naokiiwakami/envelope-generator/hardware/envelope-generator.kicad_pcb

## KiCad design hardware/envelope-generator.kicad_pcb (2026-04-16)

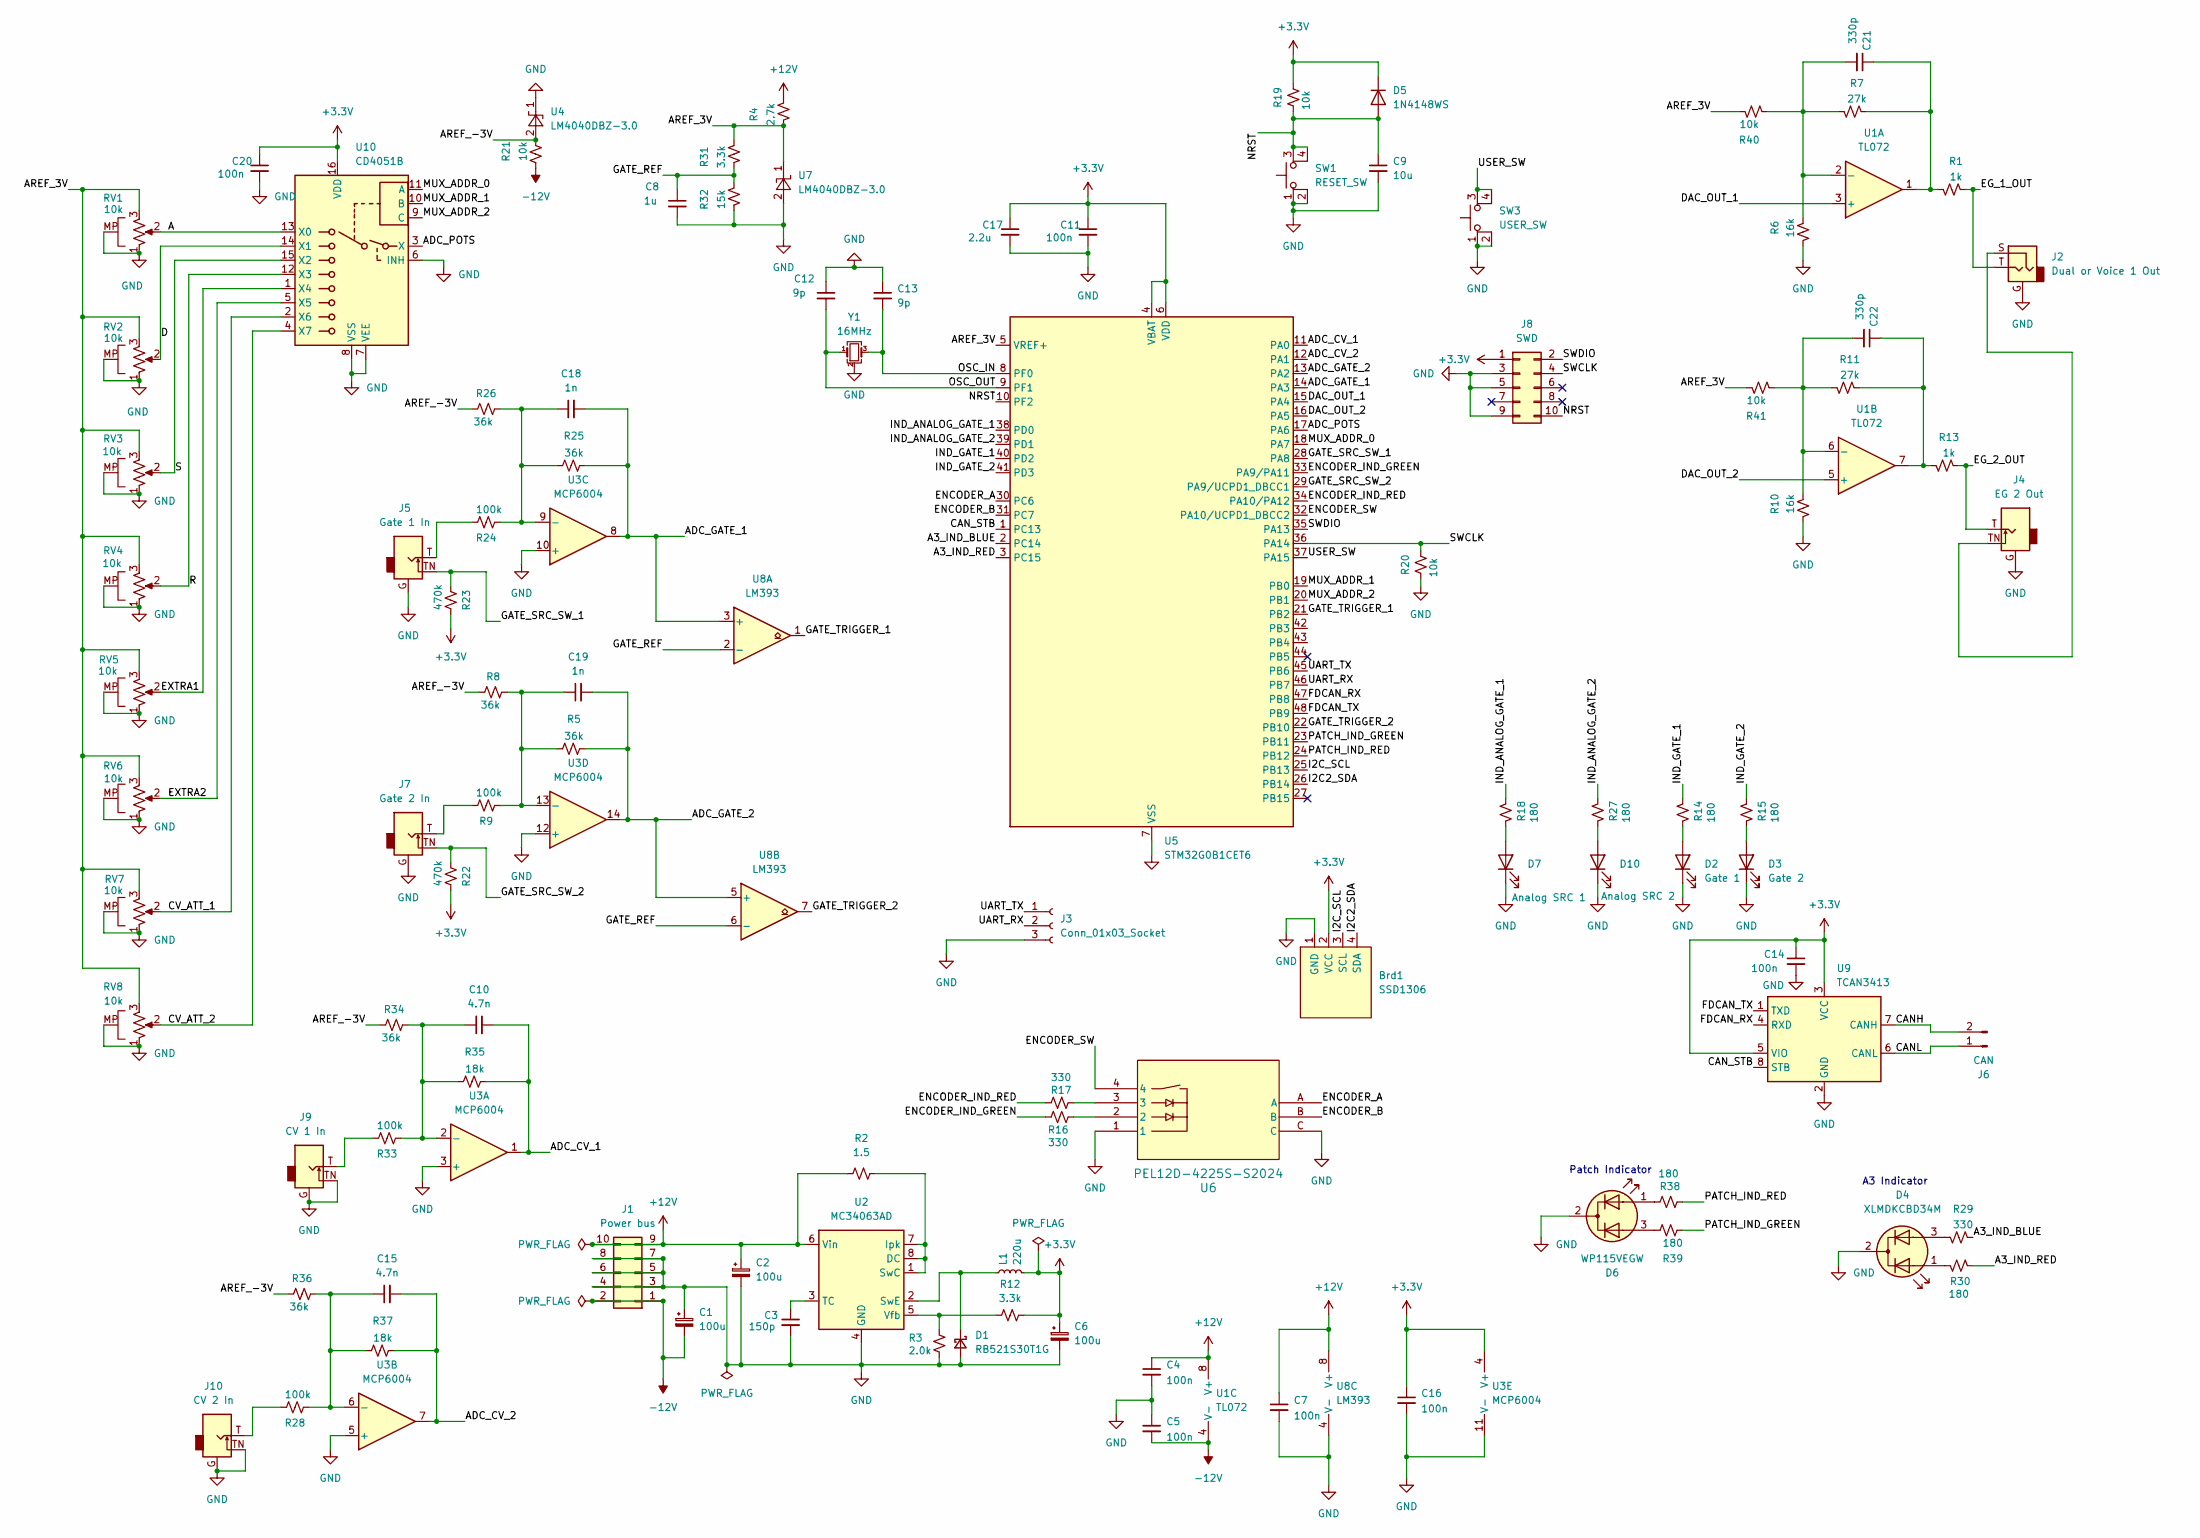
[picture p1: schematic envelope-generator.kicad_sch, Humps D]

Parts:
Brd1: SSD1306; 128x64OLED_aki
C1, C2, C6: 100u; CP_Elec_6.3x5.4_Nichicon
C3: 150p; C_0603_1608Metric
C4, C5, C7, C16: 100n; C_0603_1608Metric
C8: 1u; C_0603_1608Metric_Pad1.08x0.95mm_HandSolder
C9: 10u; C_0805_2012Metric
C10, C15: 4.7n; C_0603_1608Metric_Pad1.08x0.95mm_HandSolder
C11, C14, C20: 100n; C_0603_1608Metric_Pad1.08x0.95mm_HandSolder
C12, C13: 9p; C_0603_1608Metric_Pad1.08x0.95mm_HandSolder
C17: 2.2u; C_0603_1608Metric_Pad1.08x0.95mm_HandSolder
C18, C19: 1n; C_0603_1608Metric_Pad1.08x0.95mm_HandSolder
C21, C22: 330p; C_0603_1608Metric_Pad1.08x0.95mm_HandSolder
D1: RB521S30T1G; D_SOD-523
D2: Gate 1; LED_D3.0mm
D3: Gate 2; LED_D3.0mm
D4: XLMDKCBD34M; LED-3.0mm-3
D5: 1N4148WS; D_SOD-323
D6: WP115VEGW; LED-3.0mm-3
D7: Analog SRC 1; LED_D3.0mm
D10: Analog SRC 2; LED_D3.0mm
J1: Power bus; IDC-Header_2x05_P2.54mm_Vertical
J2: Dual or Voice 1 Out; Thonkiconn_Stereo
J3: Conn_01x03_Socket; PinSocket_1x03_P1.27mm_Vertical
J4: EG 2 Out; Thonkiconn
J5: Gate 1 In; Thonkiconn
J6: CAN; Molex_KK-254_AE-6410-02A_1x02_P2.54mm_Vertical
J7: Gate 2 In; Thonkiconn
J8: SWD; CONN_2x10_3220-10-0100-00_CNC
J9: CV 1 In; Thonkiconn
J10: CV 2 In; Thonkiconn
L1: 220u; L_1210_3225Metric
R1, R13: 1k; R_0603_1608Metric
R2: 1.5; R_0603_1608Metric
R3: 2.0k; R_0603_1608Metric
R4: 2.7k; R_0603_1608Metric_Pad0.98x0.95mm_HandSolder
R5, R8, R25, R26, R34, R36: 36k; R_0603_1608Metric_Pad0.98x0.95mm_HandSolder
R6, R10: 16k; R_0603_1608Metric
R7, R11: 27k; R_0603_1608Metric
R9, R24, R28, R33: 100k; R_0603_1608Metric_Pad0.98x0.95mm_HandSolder
R12: 3.3k; R_0603_1608Metric
R14, R15, R18, R27, R30: 180; R_0603_1608Metric
R16, R17, R29: 330; R_0603_1608Metric
R19, R20, R21: 10k; R_0603_1608Metric_Pad0.98x0.95mm_HandSolder
R22, R23: 470k; R_0603_1608Metric_Pad0.98x0.95mm_HandSolder
R31: 3.3k; R_0603_1608Metric_Pad0.98x0.95mm_HandSolder
R32: 15k; R_0603_1608Metric_Pad0.98x0.95mm_HandSolder
R35, R37: 18k; R_0603_1608Metric_Pad0.98x0.95mm_HandSolder
R38, R39: 180; R_0603_1608Metric_Pad0.98x0.95mm_HandSolder
R40, R41: 10k; R_0603_1608Metric
RV1, RV2, RV3, RV4, RV5, RV6, RV7, RV8: 10k; ALPHA_9MM
SW1: RESET_SW; Panasonic_EVQ_Q2
SW3: USER_SW; SW4_1825910-B_TEC
U1: TL072; SOT-23-8
U2: MC34063AD; SOIC-8_3.9x4.9mm_P1.27mm
U3: MCP6004; SOIC-14_3.9x8.7mm_P1.27mm
U4, U7: LM4040DBZ-3.0; SOT-23
U5: STM32G0B1CET6; LQFP-48_7x7mm_P0.5mm
U6: PEL12D-4225S-S2024; TO_4225S-S2024
U8: LM393; SOIC-8_3.9x4.9mm_P1.27mm
U9: TCAN3413; TSOT-23-8
U10: CD4051B; TSSOP-16_4.4x5mm_P0.65mm
Y1: 16MHz; Crystal_SMD_Abracon_ABM8G-4Pin_3.2x2.5mm

Connections:
+3.3V: Brd1.2 (VCC), C6.1, C11.1, C14.1, C16.1, C17.1, C20.1, D5.1 (K), J8.1, L1.2, R12.1, R19.2, R22.2, R23.2, U3.4 (V+), U5.4 (VBAT), U5.6 (VDD), U9.3 (VCC), U9.5 (VIO), U10.16 (VDD)
+12V: C2.1, C4.1, C7.1, J1.9, J1.10, R2.1, R4.2, U1.8 (V+), U2.6 (Vin), U8.8 (V+)
-12V: C1.2, C5.2, J1.1, J1.2, R21.2, U1.4 (V-)
/A: RV1.2, U10.13 (X0)
/A3_IND_BLUE: R29.1, U5.2 (PC14)
/A3_IND_RED: R30.1, U5.3 (PC15)
/ADC_CV_1: C10.2, R35.1, U3.1, U5.11 (PA0)
/ADC_CV_2: C15.2, R37.1, U3.7, U5.12 (PA1)
/ADC_GATE_1: C18.2, R25.1, U3.8, U5.14 (PA3), U8.3 (+)
/ADC_GATE_2: C19.2, R5.1, U3.14, U5.13 (PA2), U8.5 (+)
/ADC_POTS: U5.17 (PA6), U10.3 (X)
/AREF_3V: R4.1, R31.2, R40.1, R41.1, RV1.3, RV2.3, RV3.3, RV4.3, RV5.3, RV6.3, RV7.3, RV8.3, U5.5 (VREF+), U7.1 (K)
/AREF_-3V: R8.1, R21.1, R26.1, R34.1, R36.1, U4.2 (A)
/CANH: J6.2, U9.7 (CANH)
/CANL: J6.1, U9.6 (CANL)
/CAN_STB: U5.1 (PC13), U9.8 (STB)
/CV_ATT_1: RV7.2, U10.2 (X6)
/CV_ATT_2: RV8.2, U10.4 (X7)
/D: RV2.2, U10.14 (X1)
/DAC_OUT_1: U1.3 (+), U5.15 (PA4)
/DAC_OUT_2: U1.5 (+), U5.16 (PA5)
/EG_1_OUT: J2.T, R1.1
/EG_2_OUT: J4.T, R13.1
/ENCODER_A: U5.30 (PC6), U6.A
/ENCODER_B: U5.31 (PC7), U6.B
/ENCODER_IND_GREEN: R16.1, U5.33 (PA9/PA11)
/ENCODER_IND_RED: R17.2, U5.34 (PA10/PA12)
/ENCODER_SW: U5.32 (PA10/UCPD1_DBCC2), U6.4
/EXTRA1: RV5.2, U10.1 (X4)
/EXTRA2: RV6.2, U10.5 (X5)
/FDCAN_RX: U5.47 (PB8), U9.4 (RXD)
/FDCAN_TX: U5.48 (PB9), U9.1 (TXD)
/GATE_REF: C8.1, R31.1, R32.2, U8.2 (-), U8.6 (-)
/GATE_SRC_SW_1: J5.TN, R23.1, U5.28 (PA8)
/GATE_SRC_SW_2: J7.TN, R22.1, U5.29 (PA9/UCPD1_DBCC1)
/GATE_TRIGGER_1: U5.21 (PB2), U8.1
/GATE_TRIGGER_2: U5.22 (PB10), U8.7
/I2C2_SDA: Brd1.4 (SDA), U5.26 (PB14)
/I2C_SCL: Brd1.3 (SCL), U5.25 (PB13)
/IND_ANALOG_GATE_1: R18.1, U5.38 (PD0)
/IND_ANALOG_GATE_2: R27.1, U5.39 (PD1)
/IND_GATE_1: R14.1, U5.40 (PD2)
/IND_GATE_2: R15.1, U5.41 (PD3)
/MUX_ADDR_0: U5.18 (PA7), U10.11 (A)
/MUX_ADDR_1: U5.19 (PB0), U10.10 (B)
/MUX_ADDR_2: U5.20 (PB1), U10.9 (C)
/NRST: C9.1, D5.2 (A), J8.10, R19.1, SW1.3, SW1.4, U5.10 (PF2)
/OSC_IN: C13.2, U5.8 (PF0), Y1.3
/OSC_OUT: C12.2, U5.9 (PF1), Y1.1
/PATCH_IND_GREEN: R39.1, U5.23 (PB11)
/PATCH_IND_RED: R38.1, U5.24 (PB12)
/R: RV4.2, U10.12 (X3)
/S: RV3.2, U10.15 (X2)
/SWCLK: J8.4, R20.2, U5.36 (PA14)
/SWDIO: J8.2, U5.35 (PA13)
/UART_RX: J3.2, U5.46 (PB7)
/UART_TX: J3.1, U5.45 (PB6)
/USER_SW: SW3.3, SW3.4, U5.37 (PA15)
GND: Brd1.1 (GND), C1.1, C2.2, C3.2, C4.2, C5.1, C6.2, C7.2, C8.2, C9.2, C11.2, C12.1, C13.1, C14.2, C16.2, C17.2, C20.2, D1.2 (A), D2.1 (K), D3.1 (K), D4.2 (K), D6.2 (K), D7.1 (K), D10.1 (K), J1.3, J1.4, J1.5, J1.6, J1.7, J1.8, J2.G, J3.3, J4.G, J5.G, J7.G, J8.3, J8.5, J8.9, J9.G, J9.TN, J10.G, J10.TN, R3.1, R6.2, R10.2, R20.1, R32.1, RV1.1, RV1.MP, RV2.1, RV2.MP, RV3.1, RV3.MP, RV4.1, RV4.MP, RV5.1, RV5.MP, RV6.1, RV6.MP, RV7.1, RV7.MP, RV8.1, RV8.MP, SW1.1, SW1.2, SW3.1, SW3.2, U2.4 (GND), U3.3 (+), U3.5 (+), U3.10 (+), U3.11 (V-), U3.12 (+), U4.1 (K), U5.7 (VSS), U6.1, U6.C, U7.2 (A), U8.4 (V-), U9.2 (GND), U10.6 (INH), U10.7 (VEE), U10.8 (VSS), Y1.2 (G), Y1.4 (G)
unnamed: C21.1, R1.2, R7.1, U1.1
unnamed: C22.1, R11.1, R13.2, U1.7
unnamed: D1.1 (K), L1.1, U2.2 (SwE)
unnamed: D2.2 (A), R14.2
unnamed: D3.2 (A), R15.2
unnamed: D4.1 (A1), R30.2
unnamed: D4.3 (A2), R29.2
unnamed: D6.1 (A1), R38.2
unnamed: D6.3 (A2), R39.2
unnamed: D7.2 (A), R18.2
unnamed: D10.2 (A), R27.2
unnamed: J2.S, J4.TN
unnamed: J5.T, R24.2
unnamed: J7.T, R9.2
unnamed: J9.T, R33.2
unnamed: J10.T, R28.2
unnamed: R16.2, U6.2
unnamed: R17.1, U6.3
unnamed: C21.2, R6.1, R7.2, R40.2, U1.2 (-)
unnamed: C22.2, R10.1, R11.2, R41.2, U1.6 (-)
unnamed: R2.2, U2.1 (SwC), U2.7 (Ipk), U2.8 (DC)
unnamed: C3.1, U2.3 (TC)
unnamed: R3.2, R12.2, U2.5 (Vfb)
unnamed: C10.1, R33.1, R34.2, R35.2, U3.2 (-)
unnamed: C15.1, R28.1, R36.2, R37.2, U3.6 (-)
unnamed: C18.1, R24.1, R25.2, R26.2, U3.9 (-)
unnamed: C19.1, R5.2, R8.2, R9.1, U3.13 (-)

Notes on the sheet:
Patch Indicator
A3 Indicator

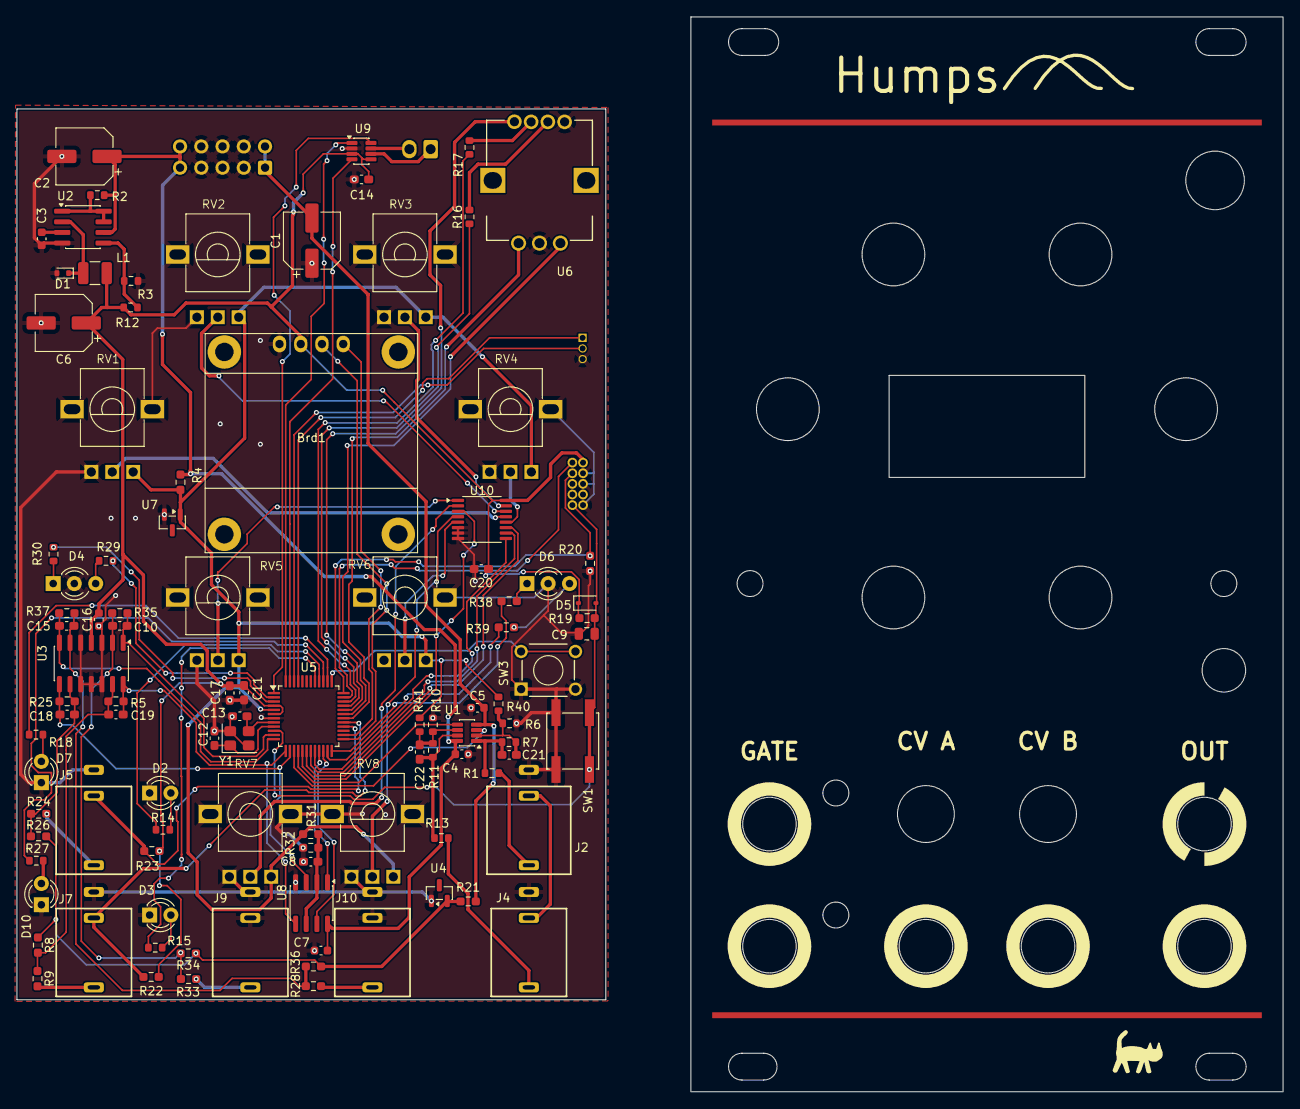
[picture p2: board envelope-generator.kicad_pcb from above]

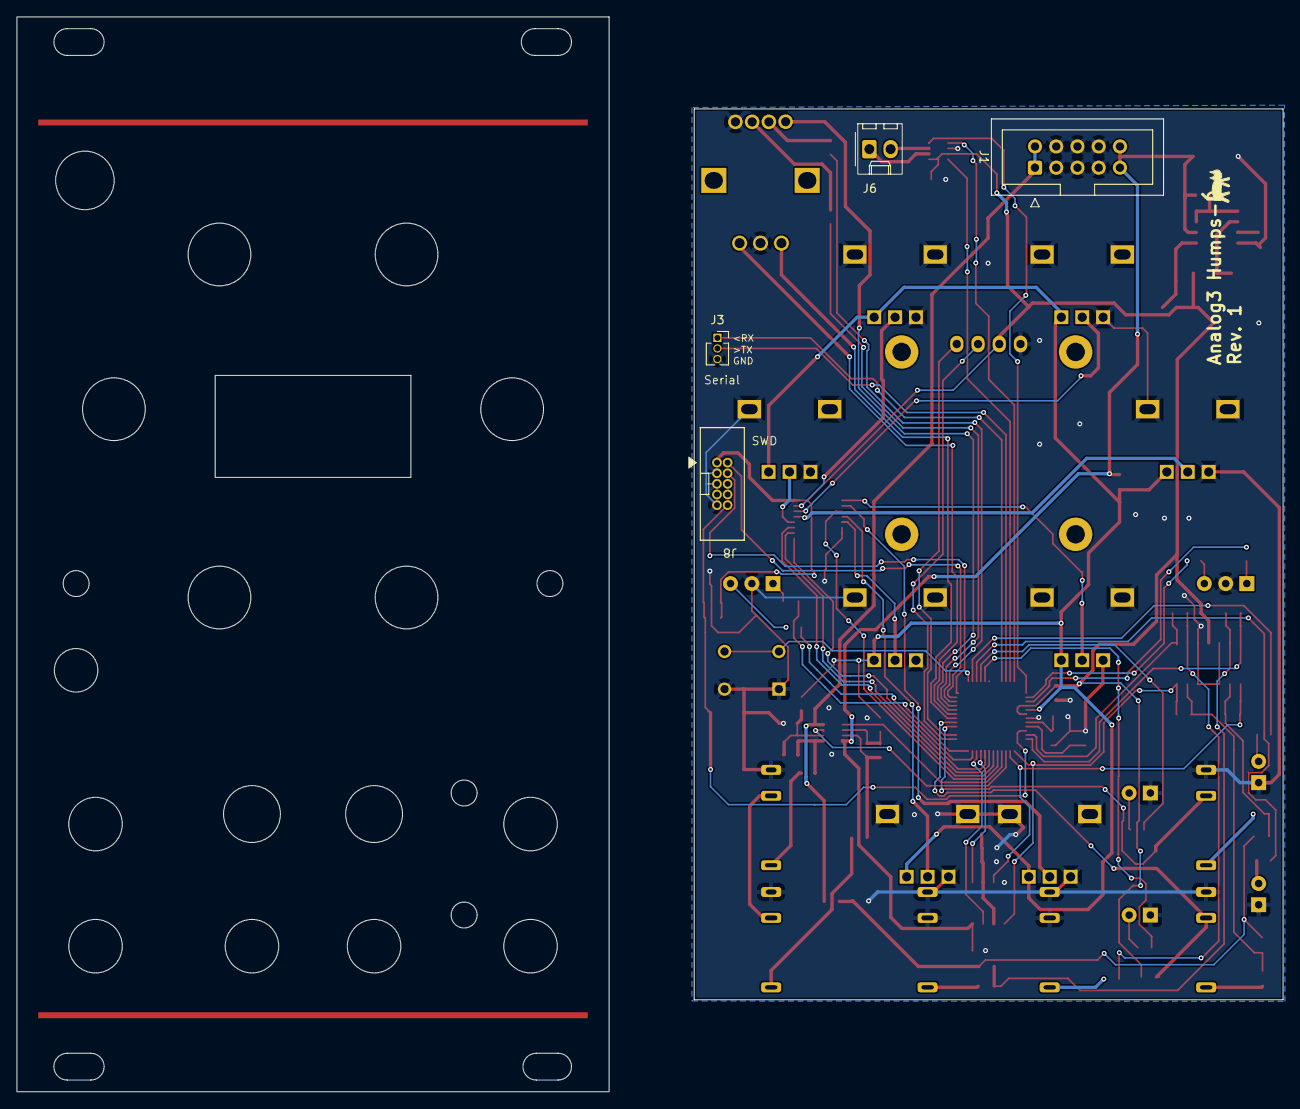
[picture p3: board envelope-generator.kicad_pcb from below]

Board: 2 copper layers, 70.4 x 106.5 mm, 105 parts (4 on the bottom side), 86 nets.

Other parts of the board:
SSD1306: 128x64OLED; 128x64 OLED Window
