naokiiwakami/envelope-generator/firmware/src/input_reader.rs

use analog3::{
    definitions::Value,
    storage::{self, load_u16},
};
use defmt::{self, debug};
use embassy_executor::Spawner;
use embassy_futures::select::{Either, select};
use embassy_stm32::{
    Peri,
    adc::{Adc, SampleTime},
    dma,
    exti::ExtiInput,
    flash::Error,
    gpio::{Input, Level, Output},
    mode::Async,
    peripherals::*,
};
use embassy_stm32::{adc::AdcChannel, bind_interrupts};
use embassy_sync::{
    blocking_mutex::raw::ThreadModeRawMutex,
    channel::{self, Channel},
    signal::Signal,
    watch::{self, Watch},
};
use embassy_time::Timer;

use crate::{
    addresses::{ADDR_CV_OFFSET_A, ADDR_GATE_TRIGGER_POINT_1},
    definitions::{PotKind, Reply},
    envelope_generator::{
        EG_CHANNEL_SIZE, EgRequest, GateEventType, VoiceId, get_eg_request_sender,
    },
};

bind_interrupts!(struct Irqs {
    DMA1_CHANNEL1 => dma::InterruptHandler<DMA1_CH1>;
});

// communications ///////////////////////////////
static WATCH_READER: Watch<ThreadModeRawMutex, InputReaderInfo, 2> = Watch::new();
static CHANNEL_REQUEST: Channel<ThreadModeRawMutex, InputReaderRequest, 2> = Channel::new();
static SIGNAL_GATE_1_READING: Signal<ThreadModeRawMutex, u16> = Signal::new();
static SIGNAL_GATE_2_READING: Signal<ThreadModeRawMutex, u16> = Signal::new();
static SIGNAL_STORAGE: Signal<ThreadModeRawMutex, Result<Value, Error>> = Signal::new();

/// ADC resources
pub struct AdcResources {
    pub adc: Adc<'static, ADC1>,
    pub dma: Peri<'static, DMA1_CH1>,

    pub mux_addr_0: Output<'static>,
    pub mux_addr_1: Output<'static>,
    pub mux_addr_2: Output<'static>,

    pub pots: Peri<'static, PA6>,

    pub gate_1: Peri<'static, PA3>,
    pub gate_2: Peri<'static, PA2>,

    pub cv_a: Peri<'static, PA0>,
    pub cv_b: Peri<'static, PA1>,
}

#[derive(Clone)]
pub struct PotInfo {
    pub kind: PotKind,
    pub value: u16,
}

#[derive(Clone)]
pub struct CvInfo {
    pub cv_a: i16,
    pub cv_b: i16,
}

#[derive(Clone)]
pub struct InputReaderInfo {
    pub pot_info: PotInfo,
    pub cv_info: CvInfo,
}

impl InputReaderInfo {
    /// create a blank info
    pub fn new(pot_kind: PotKind) -> Self {
        Self {
            pot_info: PotInfo {
                kind: pot_kind,
                value: 0,
            },
            cv_info: CvInfo { cv_a: 0, cv_b: 0 },
        }
    }
}

pub enum InputReaderRequest {
    ReadVelocity {
        voice_id: VoiceId,
    },
    SetCvOffsets {
        offset_a: i16,
        offset_b: i16,
        save: bool,
    },
    SmashForGateOffset {
        voice_id: VoiceId,
        reply: &'static Signal<ThreadModeRawMutex, Reply>,
    },
}

pub async fn start(
    spawner: Spawner,
    resources: AdcResources,
    gate_src_sw_1: Input<'static>,
    gate_src_sw_2: Input<'static>,
    ind_analog_gate_1: Output<'static>,
    ind_analog_gate_2: Output<'static>,
    gate_trigger_1: ExtiInput<'static, Async>,
    gate_trigger_2: ExtiInput<'static, Async>,
) {
    let mut input_reader = InputReader::new(resources);
    input_reader.load_cv_offsets().await;
    input_reader.load_gate_offsets().await;
    spawner.spawn(run_input_reader(input_reader).unwrap());
    let physical_gate_1 = PhysicalGate::new(
        gate_src_sw_1,
        ind_analog_gate_1,
        gate_trigger_1,
        VoiceId::Voice1,
    );
    let physical_gate_2 = PhysicalGate::new(
        gate_src_sw_2,
        ind_analog_gate_2,
        gate_trigger_2,
        VoiceId::Voice2,
    );
    spawner.spawn(run_physical_gate(physical_gate_1).unwrap());
    spawner.spawn(run_physical_gate(physical_gate_2).unwrap());
}

#[inline]
async fn get_change_receiver<T>(
    watch: &'static Watch<ThreadModeRawMutex, T, 2>,
) -> watch::Receiver<'static, ThreadModeRawMutex, T, 2>
where
    T: Clone,
{
    let mut sleep_millis = 1;
    loop {
        if let Some(receiver) = watch.receiver() {
            return receiver;
        }
        // exponential back off
        Timer::after_millis(sleep_millis).await;
        sleep_millis *= 2;
    }
}

pub async fn get_reader_info_receiver()
-> watch::Receiver<'static, ThreadModeRawMutex, InputReaderInfo, 2> {
    get_change_receiver(&WATCH_READER).await
}

pub fn get_reader_request_sender()
-> channel::Sender<'static, ThreadModeRawMutex, InputReaderRequest, 2> {
    CHANNEL_REQUEST.sender()
}

static MUX_ADDRESSES: [(Level, Level, Level, PotKind); 8] = [
    (Level::Low, Level::Low, Level::Low, PotKind::Attack),
    (Level::Low, Level::Low, Level::High, PotKind::Decay),
    (Level::Low, Level::High, Level::Low, PotKind::Sustain),
    (Level::Low, Level::High, Level::High, PotKind::Release),
    (Level::High, Level::Low, Level::Low, PotKind::Extra1),
    (Level::High, Level::Low, Level::High, PotKind::Extra2),
    (Level::High, Level::High, Level::Low, PotKind::CvDepthA),
    (Level::High, Level::High, Level::High, PotKind::CvDepthB),
];

#[embassy_executor::task]
async fn run_input_reader(mut input_reader: InputReader) {
    input_reader.run().await;
}

struct InputReader {
    // peripherals
    resources: AdcResources,

    // pot reading
    pot_index: usize,

    // CV offsets
    cv_offset_a: i16,
    cv_offset_b: i16,

    // gate offsets
    gate_offset: [u16; 2],
}

impl InputReader {
    pub fn new(resources: AdcResources) -> Self {
        Self {
            resources,
            pot_index: 0,
            cv_offset_a: 0,
            cv_offset_b: 0,
            gate_offset: [0; 2],
        }
    }

    pub async fn run(&mut self) {
        let request_receiver = CHANNEL_REQUEST.receiver();
        let mut reader_info_sender = WATCH_READER.sender();
        loop {
            match select(Timer::after_millis(10), request_receiver.receive()).await {
                Either::First(()) => {}
                Either::Second(request) => match request {
                    InputReaderRequest::ReadVelocity { voice_id } => {
                        self.read_velocity(voice_id).await
                    }
                    InputReaderRequest::SetCvOffsets {
                        offset_a,
                        offset_b,
                        save,
                    } => self.set_cv_offsets(offset_a, offset_b, save).await,
                    InputReaderRequest::SmashForGateOffset { voice_id, reply } => {
                        self.set_gate_offset(voice_id).await;
                        reply.signal(Reply::Void);
                    }
                },
            }
            self.regular_reading(&mut reader_info_sender).await;
        }
    }

    async fn regular_reading(
        &mut self,
        reader_info_sender: &mut watch::Sender<'_, ThreadModeRawMutex, InputReaderInfo, 2>,
    ) {
        let (pot_info, cv_info) = self.run_adc(self.pot_index).await;
        self.pot_index = (self.pot_index + 1) % MUX_ADDRESSES.len();
        reader_info_sender.send(InputReaderInfo { pot_info, cv_info });
    }

    async fn run_adc(&mut self, index: usize) -> (PotInfo, CvInfo) {
        // Set up the pot multiplexer
        let (addr2, addr1, addr0, kind) = &MUX_ADDRESSES[index];
        self.resources.mux_addr_0.set_level(*addr0);
        self.resources.mux_addr_1.set_level(*addr1);
        self.resources.mux_addr_2.set_level(*addr2);

        // run ADC
        let mut buffer = [0u16; 3];
        let mut pots = self.resources.pots.degrade_adc();
        let mut cv_a = self.resources.cv_a.degrade_adc();
        let mut cv_b = self.resources.cv_b.degrade_adc();
        let sequence = [
            (&mut pots, SampleTime::Cycles1605),
            (&mut cv_a, SampleTime::Cycles1605),
            (&mut cv_b, SampleTime::Cycles1605),
        ]
        .into_iter();
        self.resources
            .adc
            .read(
                self.resources.dma.reborrow(),
                Irqs,
                sequence,
                None,
                &mut buffer,
            )
            .await;

        // Pots pick up noise so their values do not drop to zero at the bottoms.
        // It causes noticable slight level at the edge of the configuration.
        // We subtract 4 from the original value to mitigate this problem.
        let pot_value = if buffer[2] >= 4 {
            (buffer[2] - 4) << 4
        } else {
            0
        };

        let cv_a = 32767 + self.cv_offset_a - (buffer[0] << 4) as i16;
        let cv_b = 32767 + self.cv_offset_b - (buffer[1] << 4) as i16;

        (
            PotInfo {
                kind: *kind,
                value: pot_value,
            },
            CvInfo { cv_a, cv_b },
        )
    }

    async fn read_velocity(&mut self, voice_id: VoiceId) {
        let reading = self.read_gate_value(voice_id).await;
        let offset = self.gate_offset[voice_id as usize];
        let velocity = reading.max(offset) - offset;

        match voice_id {
            VoiceId::Voice1 => SIGNAL_GATE_1_READING.signal(velocity),
            VoiceId::Voice2 => SIGNAL_GATE_2_READING.signal(velocity),
        }
    }

    async fn set_cv_offsets(&mut self, offset_a: i16, offset_b: i16, save: bool) {
        debug!("SetCvOffsets received: {:#x} {:#x}", offset_a, offset_b);
        self.cv_offset_a = offset_a;
        self.cv_offset_b = offset_b;
        if save {
            self.save_cv_offsets().await;
        }
    }

    async fn set_gate_offset(&mut self, voice_id: VoiceId) {
        let reading = self.read_gate_value(voice_id).await;
        self.gate_offset[voice_id as usize] = reading.max(10) - 10;
        debug!(
            "gate offset {}={}",
            voice_id as usize, self.gate_offset[voice_id as usize]
        );
        Self::save_gate_offset(voice_id as u16, reading).await;
    }

    async fn read_gate_value(&mut self, voice_id: VoiceId) -> u16 {
        let mut buffer = [0u16; 1];
        let channel = match voice_id {
            VoiceId::Voice1 => &mut self.resources.gate_1.degrade_adc(),
            VoiceId::Voice2 => &mut self.resources.gate_2.degrade_adc(),
        };
        let sequence = [(channel, SampleTime::Cycles1605)].into_iter();
        self.resources
            .adc
            .read(
                self.resources.dma.reborrow(),
                Irqs,
                sequence,
                None,
                &mut buffer,
            )
            .await;

        let reading = !((buffer[0]) << 4);
        reading
    }

    pub async fn load_cv_offsets(&mut self) {
        self.cv_offset_a = Self::load_cv_offset(0).await;
        self.cv_offset_b = Self::load_cv_offset(1).await;
        debug!(
            "loaded CV offsets: a={}, b={}",
            self.cv_offset_a, self.cv_offset_b
        );
    }

    async fn load_cv_offset(index: u16) -> i16 {
        let saved_offset = load_u16(ADDR_CV_OFFSET_A + index * 2, &SIGNAL_STORAGE).await;
        if saved_offset == u16::MAX {
            0
        } else {
            (saved_offset as i32 - 0x8000) as i16
        }
    }

    async fn save_cv_offsets(&mut self) {
        Self::save_cv_offset(0, self.cv_offset_a).await;
        Self::save_cv_offset(1, self.cv_offset_b).await;
    }

    async fn save_cv_offset(index: u16, offset: i16) {
        let save_value = (offset as i32 + 0x8000) as u16;
        storage::save(
            ADDR_CV_OFFSET_A + index * 2,
            Value::U16(save_value),
            &SIGNAL_STORAGE,
        )
        .await
        .unwrap();
    }

    pub async fn load_gate_offsets(&mut self) {
        self.gate_offset[0] = Self::load_gate_offset(0).await;
        self.gate_offset[1] = Self::load_gate_offset(1).await;
        debug!(
            "loaded CV offsets: a={}, b={}",
            self.cv_offset_a, self.cv_offset_b
        );
    }

    async fn load_gate_offset(index: u16) -> u16 {
        let saved_offset = load_u16(ADDR_GATE_TRIGGER_POINT_1 + index * 2, &SIGNAL_STORAGE).await;
        if saved_offset == u16::MAX {
            0
        } else {
            saved_offset
        }
    }

    async fn save_gate_offset(index: u16, offset: u16) {
        storage::save(
            ADDR_GATE_TRIGGER_POINT_1 + index * 2,
            Value::U16(offset),
            &SIGNAL_STORAGE,
        )
        .await
        .unwrap();
    }
}

#[embassy_executor::task(pool_size = 2)]
async fn run_physical_gate(mut analog_gate: PhysicalGate) {
    analog_gate.run().await;
}

struct PhysicalGate {
    src_sw: Input<'static>,
    ind_analog_gate: Output<'static>,
    trigger: ExtiInput<'static, Async>,

    voice_id: VoiceId,
    state: PhysicalGateState,

    request_sender: channel::Sender<'static, ThreadModeRawMutex, EgRequest, EG_CHANNEL_SIZE>,
}

impl PhysicalGate {
    pub fn new(
        src_sw: Input<'static>,
        ind_analog_gate: Output<'static>,
        trigger: ExtiInput<'static, Async>,
        voice_id: VoiceId,
    ) -> Self {
        Self {
            src_sw,
            ind_analog_gate,
            trigger,
            voice_id,
            state: PhysicalGateState::Disabled,
            request_sender: get_eg_request_sender(),
        }
    }

    pub async fn run(&mut self) {
        loop {
            match self.state {
                PhysicalGateState::Disabled => {
                    Timer::after_millis(10).await;
                    if self.src_sw.is_high() {
                        debug!(
                            "Physical gate {:?} enabled, state={:?}",
                            self.voice_id, self.state
                        );
                        self.state = PhysicalGateState::GateOff;
                        self.ind_analog_gate.set_high();
                        self.request_sender
                            .send(EgRequest::GateEvent {
                                id: self.voice_id.clone(),
                                event: GateEventType::PhysicalGateEnabled,
                            })
                            .await;
                    }
                }
                _ => self.run_analog_gate().await,
            }
        }
    }

    async fn run_analog_gate(&mut self) {
        let mut request_sender = CHANNEL_REQUEST.sender();
        loop {
            match self.state {
                PhysicalGateState::Disabled => {
                    break;
                }
                PhysicalGateState::GateOff => match select(
                    self.trigger.wait_for_falling_edge(),
                    Timer::after_millis(10),
                )
                .await
                {
                    Either::First(()) => self.handle_gate_on(&mut request_sender).await,
                    Either::Second(()) => self.check_gate_switch().await,
                },
                PhysicalGateState::GateOn => {
                    match select(self.trigger.wait_for_rising_edge(), Timer::after_millis(10)).await
                    {
                        Either::First(()) => self.handle_gate_off().await,
                        Either::Second(()) => self.check_gate_switch().await,
                    }
                }
            }
        }
    }

    async fn handle_gate_on(
        &mut self,
        sender: &mut channel::Sender<'static, ThreadModeRawMutex, InputReaderRequest, 2>,
    ) {
        self.state = PhysicalGateState::GateOn;
        debug!("gate on");
        Timer::after_micros(500).await;
        sender
            .send(InputReaderRequest::ReadVelocity {
                voice_id: self.voice_id.clone(),
            })
            .await;
        let velocity: u16 = match self.voice_id {
            VoiceId::Voice1 => SIGNAL_GATE_1_READING.wait().await,
            VoiceId::Voice2 => SIGNAL_GATE_2_READING.wait().await,
        };
        self.request_sender
            .send(EgRequest::GateEvent {
                id: self.voice_id.clone(),
                event: GateEventType::GateOn { velocity },
            })
            .await;
    }

    async fn handle_gate_off(&mut self) {
        self.state = PhysicalGateState::GateOff;
        self.request_sender
            .send(EgRequest::GateEvent {
                id: self.voice_id.clone(),
                event: GateEventType::GateOff,
            })
            .await;
    }

    async fn check_gate_switch(&mut self) {
        // TODO: assert physical gate enabled
        if self.src_sw.is_low() {
            debug!(
                "Physical gate {:?} disabled, state={:?}",
                self.voice_id, self.state
            );
            if !matches!(self.state, PhysicalGateState::GateOff) {
                self.request_sender
                    .send(EgRequest::GateEvent {
                        id: self.voice_id.clone(),
                        event: GateEventType::GateOff,
                    })
                    .await;
            }
            self.request_sender
                .send(EgRequest::GateEvent {
                    id: self.voice_id.clone(),
                    event: GateEventType::PhysicalGateDisabled,
                })
                .await;
            self.ind_analog_gate.set_low();
            self.state = PhysicalGateState::Disabled
        }
    }
}

#[derive(Debug, defmt::Format)]
enum PhysicalGateState {
    Disabled,
    GateOff,
    GateOn,
}
