naokiiwakami/envelope-generator/firmware/src/control_panel/display/definitions.rs

pub const LEFT: i32 = 0;
pub const RIGHT: i32 = 127;
pub const TOP: i32 = 0;
pub const BOTTOM: i32 = 28;
pub const N_BOTTOM: i32 = 56;
pub const EDGE_BOTTOM: i32 = 63;
pub const LOWER_BASELINE: i32 = EDGE_BOTTOM - 14;
