naokiiwakami/envelope-generator/firmware/src/envelope_generator/calib_engine.rs

use crate::envelope_generator::OutputPolarity;
use crate::input_reader::InputReaderInfo;

use super::config::EgConfig;
use super::definitions::{Engine, VoiceParams};

pub struct CalibEngine {
    polarity: OutputPolarity,
}

impl Engine for CalibEngine {
    fn new() -> Self {
        Self {
            polarity: OutputPolarity::Positive,
        }
    }

    fn initialize(&mut self, _voice_index: usize, _config: &EgConfig) {}

    fn update_params(&mut self, voice_index: usize, config: &EgConfig, _input: &InputReaderInfo) {
        self.polarity = config.out_polarity(voice_index);
    }

    fn gate_on(&mut self, _params: &VoiceParams) {}

    fn gate_off(&mut self) {}

    /// Generates triangular wave
    fn update(&mut self, params: &VoiceParams) -> u16 {
        let out = params.output_level + params.out_zero_point;
        out
    }
}
