naokiiwakami/envelope-generator/(commit log)

2025-11-30 Merge PoC code (#1)
    * initial commit
    * Introduce new component 'EnvelopeGenerator'
    * Generalize MCP47x6 DAC handling methods
    * Make release time configurable
    * Initial ADSR implementation
    * minor fixes
    * Improve mechanism to update envelope generator units to eliminate intermittent pop noises
    * Fix bugs
    * Double precision of envelope calculation
    * bugfix
    * Avoid calculations in interrupt handlers
    * try ADDSR
    * Try PWM
    * Consolidate timer to update EG to TIM3 to avoid potential risk of beating effect
    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
    [envelope-generator.kicad_pcb, envelope-generator.kicad_sch]
2026-02-15 PCB design the first iteration
    [envelope-generator.kicad_pcb, envelope-generator.kicad_sch]
2026-03-13 humps rev 0
    [envelope-generator.kicad_pcb, envelope-generator.kicad_sch]
2026-03-13 (try to) fix bug in menu index tracking
    [control_panel.rs]
2026-03-16 Add functionality to switch EG type
2026-03-18 Enable showing current engine type
2026-03-18 Add basic framework to display for each engine type
2026-03-18 Issue 6 (#10)
    * Add basic framework to display for each engine type
    * Start using fixed
    * Replace values in ADSR engine by fixed types
    * Use fixed for the ADDSR engine
    * Reverse the polarity of delta
    * Rename AddsrEngine to TwoDecaysEngine
    [envelope_generator.rs, two_decays_engine.rs]
2026-03-19 fix a bug in displaying pot position
    [display.rs]
2026-03-19 Issue #11 - Simplify the ADSR engine implementation
    [adsr_engine.rs, definitions.rs, envelope_generator.rs, linear_engine.rs, menu.rs, two_decays_engine.rs]
2026-03-19 Issue #2 - Replace watches for receiving reply by signals
    [control_panel.rs, diagnoser.rs, envelope_generator.rs, mod.rs, patch_controller.rs]
2026-03-20 issue #16 Eliminate dependency on crate fixed
    [adsr_engine.rs, definitions.rs, linear_engine.rs, two_decays_engine.rs]
2026-03-20 Issue #8 Add new engine "ParaDecays" (#17)
    * Adding adsr-dd, wip
    * Done with initial implementation of adsr-strum
    * done
    [control_panel.rs, definitions.rs, display.rs, envelope_generator.rs, linear_engine.rs, menu.rs, menu_mode.rs, para_decays_engine.rs]
2026-03-24 Issue #9 - Replace the display driver by developed Ssd1306Lite (#19)
    * Replace the display driver by the developed Ssd1306Lite
    * Update dependency
    [control_panel.rs, diag_engine.rs, diagnoser.rs, display.rs, menu_mode.rs]
2026-03-25 Issue #18 - Upgrade Embassy (#20)
    * upgrade embassy
    * Fixed dependency issues
    [display.rs, envelope_generator.rs, input_reader.rs, main.rs]
2026-03-25 Issue #4 - Add capability for negative output (#22)
    * Modify the circuit to enable negative output
    * Modify engines to support positive and negative output
    * Improve the way to write value to DAC
    [envelope-generator.kicad_pcb, envelope-generator.kicad_sch]
2026-03-27 Issue #13 - Add capability to calibrate the module (#24)
    * Add calibrator, wip
    * Add capability to calibrate the module, wip
    * Calibration, wip #2
    * Improve appearance
    * remove a done TODO comment
    [addresses.rs, adsr_engine.rs, calibrator.rs, config.rs, control_panel.rs, definitions.rs]
2026-03-29 Issue #3 - Save and load configuration (#27)
    * wip, storage is unstable yet
    * Move analog3 out to a crate
    [addresses.rs, config.rs, control_panel.rs, definitions.rs, diagnoser.rs, envelope_generator.rs, input_reader.rs, main.rs]
2026-03-31 Issue #28 Add note scaling (#29)
    * note scaling, wip
    * Done with ADSR note tracking
    * Code cleansing
    * covered linear engine
    * Add para decay coverage
    * Add two decays coverage
    [adsr_engine.rs, definitions.rs, envelope_generator.rs, linear_engine.rs, para_decays_engine.rs, two_decays_engine.rs, utils.rs]
2026-04-03 Issue #30 - Implement ADSR and Linear home pages (#31)
    * Make new display mode InOperation
    * move InOperation display mode to a new file
    * introduce a concept of "page" in the control panel
    * Remove OpMenu
    * Add output polarity page
    * building ADSR home, wip
    * building ADSR home, wip 2
    * rename analog gate to physical gate
    * Revert "rename analog gate to physical gate"
    This reverts commit 9c0c7e640c7240c70e493bea17cb47170256096a.
    * Rename analog gate to physical gate
    * refactoring: change EG Diag from an engine type to operation mode
    * Add toggling diag mode to the admin menu
    * Add note scaling display
    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
    [adsr_engine.rs, calibrator.rs, control_panel.rs, definitions.rs, diagnoser.rs, display.rs, envelope_generator.rs, in_operation_mode.rs]
2026-04-03 bugfix - calibration hangs
    [calibrator.rs]
2026-04-04 Issue #26 create UID by random number generator (#34)
    [envelope_generator.rs, main.rs]
2026-04-05 Issue #35 - add splash screen (#36)
    * add startup gimmick, wip
    * consolidate the splash screen logic to control-panel/display
    * code cleansing
    ---------
    [control_panel.rs, display.rs, patch_controller.rs]
2026-04-07 Issue #21 - add capability to reverse output (#39)
    * Add capability to switch output polarity, wip
    * Add capability to switch output polarity, wip 2
    * done with initial implementation
    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
    [addresses.rs, config.rs, control_panel.rs, definitions.rs, display.rs, envelope_generator.rs, in_operation_mode.rs, menu.rs]
2026-04-10 Issue #42 - Add capability to assign CV destinations (#46)
    [addresses.rs, adsr_engine.rs, calibrator.rs, config.rs, control_panel.rs, definitions.rs, diag_engine.rs, diagnoser.rs]
2026-04-10 Issue #45 send pot change notifications via EnvelopeGenerator (#48)
    [calibrator.rs, control_panel.rs, definitions.rs, diagnoser.rs, envelope_generator.rs]
2026-04-13 Issue #32 - para decay home page (#49)
    * separated home pages
    * detoxed AI poison
    * para decay home page, wip
    * para decay home page, wip 2
    * done with para decay home page, initial version
    * add center line
    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
    [adsr_home.rs, definitions.rs, display.rs, in_operation_mode.rs, linear_home.rs, menu.rs, para_decays_home.rs]
2026-04-15 Issue #50 Add capability to configure note scaling for ParaDecays and ADDSR (#52)
    * display page
    * note scaler, wip
    * trial-1
    * Revert "trial-1"
    This reverts commit 901950596044c482594fc96c3e80a096d7804c77.
    * consolidated operation actions into the ControlPanel loop to prevent EG hang
    * done initial implementation
    * Detox AI poison #1
    * Detox AI poison #2
    * eliminate some compiler warnings
    * fix awkward movement, wip
    * fix awkward movement
    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
    [addresses.rs, config.rs, control_panel.rs, definitions.rs, display.rs, envelope_generator.rs, in_operation_mode.rs]
2026-04-15 Issue #33 - Add Two Phases home page (#53)
    * initial implementation
    * Rename Two Decays
    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
    [addresses.rs, adsr_home.rs, control_panel.rs, definitions.rs, display.rs, envelope_generator.rs, home_page_helpers.rs, in_operation_mode.rs]
2026-04-16 Fix circuit and PCB issues
    [envelope-generator.kicad_pcb, envelope-generator.kicad_sch]
2026-04-21 Issue #23 - add gate trigger point calibration (#57)
    [adsr_home.rs, calib_engine.rs, calibrator.rs, control_panel.rs, definitions.rs, display.rs, envelope_generator.rs]
2026-05-02 Switch embassy to the official one
